22bits/tutupadrummachine/README.md

# tutupadrummachine
Tutupá machine is an arduino-based mechanical drum machine
