22bits/tutupadrummachine/schematic/TUTUPA V2.5sch.brd

## EAGLE design schematic/TUTUPA V2.5sch.brd (2017-04-18)

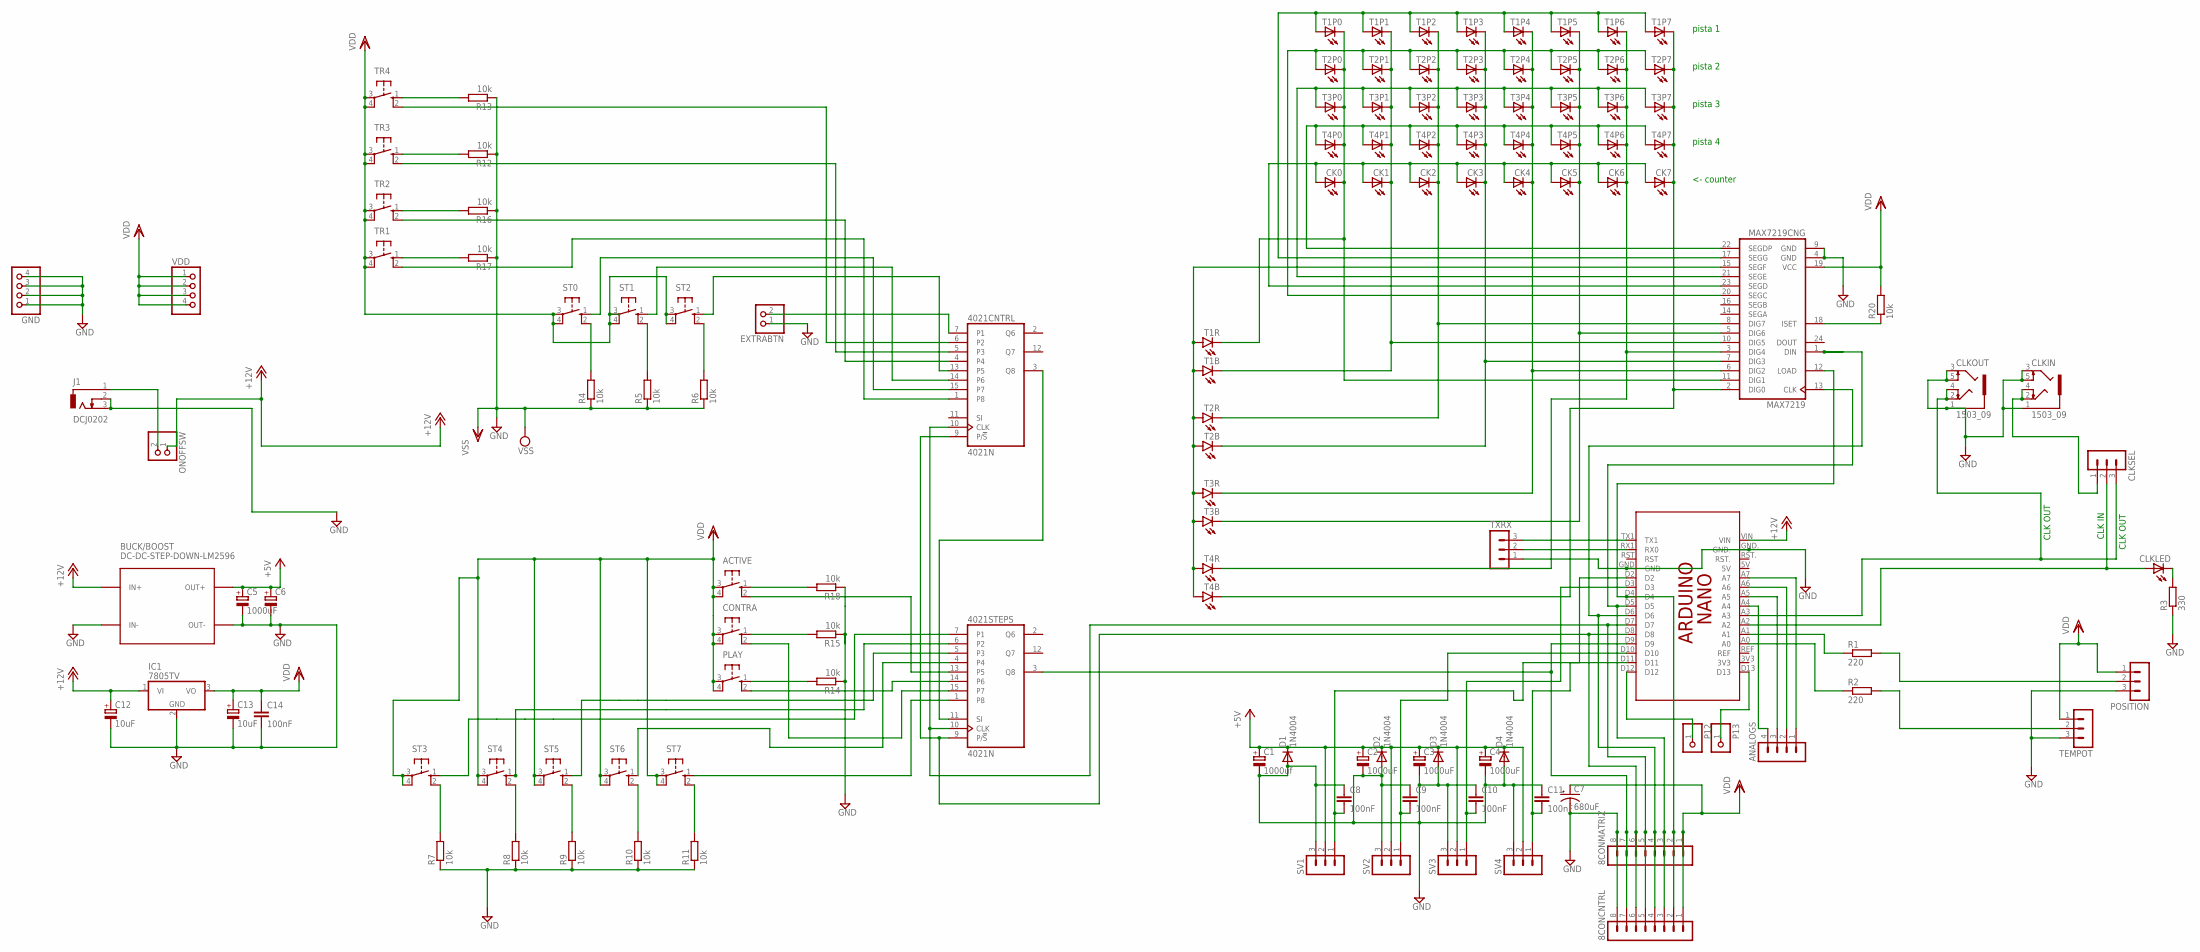
[picture p1: schematic TUTUPA V2.5sch.sch, sheet 1]

Parts:
8CONCNTRL, 8CONMATRIZ: MA08-1W
4021CNTRL, 4021STEPS: 4021N; DIL16
ACTIVE: 10-XX; B3F-10XX
ANALOGS: MA04-1
BUCK/BOOST: DC-DC-STEP-DOWN-LM2596
C1: 1000uf; E5-13
C2, C3, C4, C5: 1000uF; E5-13
C6: CPOL-EUE2.5-6; E2,5-6
C7: 680uF; E5-10,5
C8, C9, C10, C11, C14: 100nF; C050-024X044
C12, C13: 10uF; E1,8-4
CK0, CK1, CK2, CK3, CK4, CK5, CK6, CK7: LED5MM
CLKIN: 1503_09
CLKLED: LED5MM
CLKOUT: 1503_09
CLKSEL: MA03-1
CONTRA: 10-XX; B3F-10XX
D1, D2, D3, D4: 1N4004; DO41-10
EXTRABTN: PINHD-1X2; 1X02
GND: PINHD-1X4; 1X04
IC1: 7805TV; TO220V
J1: DCJ0202
MAX7219: MAX7219CNG; DIL24-3
ONOFFSW: PINHD-1X2; 1X02
P12, P13: PINHD-1X1; 1X01
PCB1: ARDUINO_NANO
PLAY: 10-XX; B3F-10XX
POSITION: MA03-1
R1, R2: 220; 0204/7
R3: 330; 0204/7
R4, R5, R6, R7, R8, R9, R10, R11, R12, R13, R14, R15, R16, R17, R18, R20: 10k; 0207/10
ST0, ST1, ST2, ST3, ST4, ST5, ST6, ST7: 10-XX; B3F-10XX
SV1, SV2, SV3, SV4: MA03-1
T1B, T1R, T2B, T2R, T3B, T3R, T4B, T4R: LED3MM
T1P0, T1P1, T1P2, T1P3, T1P4, T1P5, T1P6, T1P7, T2P0, T2P1, T2P2, T2P3, T2P4, T2P5, T2P6, T2P7, T3P0, T3P1, T3P2, T3P3, T3P4, T3P5, T3P6, T3P7, T4P0, T4P1, T4P2, T4P3, T4P4, T4P5, T4P6, T4P7: LED5MM
TEMPOT: MA03-1
TR1, TR2, TR3, TR4: 10-XX; B3F-10XX
TXRX: MA03-1
VDD: PINHD-1X4; 1X04

Connections:
+5V: BUCK/BOOST.OUT+, C1.+, C2.+, C3.+, C4.+, C5.+, C6.+, D1.C, D2.C, D3.C, D4.C, SV1.2, SV2.2, SV3.2, SV4.2
+12V: BUCK/BOOST.IN+, C12.+, IC1.1 (VI), ONOFFSW.1, PCB1.VIN
CLKINARDUINO: CLKLED.A, CLKSEL.2, PCB1.A2
CLKOUTARDUINO: CLKOUT.2, CLKOUT.4, CLKSEL.3, PCB1.A3
CONIN: CLKIN.2, CLKIN.4, CLKSEL.1
GND: 8CONCNTRL.8, 8CONMATRIZ.8, BUCK/BOOST.IN-, BUCK/BOOST.OUT-, C1.-, C2.-, C3.-, C4.-, C5.-, C6.-, C7.-, C8.1, C9.1, C10.1, C11.1, C12.-, C13.-, C14.2, CLKIN.1, CLKIN.3, CLKIN.5, CLKOUT.1, CLKOUT.3, CLKOUT.5, D1.A, D2.A, D3.A, D4.A, EXTRABTN.1, GND.1, GND.2, GND.3, GND.4, IC1.2 (GND), J1.2, J1.3, MAX7219.4 (GND), MAX7219.9 (GND), PCB1.GND, PCB1.GND., POSITION.3, R3.1, R4.1, R5.1, R6.1, R7.1, R8.1, R9.1, R10.1, R11.1, R12.1, R13.1, R14.1, R15.1, R16.1, R17.1, R18.1, SV1.3, SV2.3, SV3.3, SV4.3, TEMPOT.3, TXRX.1
unnamed: 4021CNTRL.14 (P6), ST1.1 (S)
unnamed: ANALOGS.3, PCB1.A5
unnamed: ANALOGS.2, PCB1.A6
unnamed: ANALOGS.1, PCB1.A7
unnamed: 4021CNTRL.13 (P5), ST2.1 (S)
unnamed: 4021CNTRL.7 (P1), EXTRABTN.2
unnamed: R8.2, ST4.2 (S1)
unnamed: 4021STEPS.1 (P8), ST7.1 (S)
unnamed: R17.2, TR1.1 (S)
unnamed: 4021CNTRL.15 (P7), ST0.1 (S)
unnamed: 4021CNTRL.1 (P8), TR1.2 (S1)
unnamed: 4021CNTRL.4, TR2.2 (S1)
unnamed: MAX7219.15 (SEGF), T1B.A, T1R.A, T2B.A, T2R.A, T3B.A, T3R.A, T4B.A, T4R.A
unnamed: 4021CNTRL.5 (P3), TR3.2 (S1)
unnamed: CONTRA.1 (S), R15.2
unnamed: 4021STEPS.14 (P6), PLAY.2 (S1)
unnamed: 4021STEPS.6 (P2), ST4.1 (S)
unnamed: 4021STEPS.5 (P3), ST5.1 (S)
unnamed: 4021CNTRL.6 (P2), TR4.2 (S1)
unnamed: PLAY.1 (S), R14.2
unnamed: R4.2, ST0.2 (S1)
unnamed: R5.2, ST1.2 (S1)
unnamed: R6.2, ST2.2 (S1)
unnamed: R7.2, ST3.2 (S1)
unnamed: 4021STEPS.7 (P1), ST3.1 (S)
unnamed: R9.2, ST5.2 (S1)
unnamed: R10.2, ST6.2 (S1)
unnamed: R11.2, ST7.2 (S1)
unnamed: R13.2, TR4.1 (S)
unnamed: R12.2, TR3.1 (S)
unnamed: R16.2, TR2.1 (S)
unnamed: 4021STEPS.4, ST6.1 (S)
unnamed: 4021STEPS.15 (P7), CONTRA.2 (S1)
unnamed: 4021STEPS.13 (P5), ACTIVE.2 (S1)
unnamed: ACTIVE.1 (S), R18.2
unnamed: 4021CNTRL.3 (Q8), 4021STEPS.11 (SI)
unnamed: 8CONCNTRL.5, 8CONMATRIZ.5, 4021CNTRL.10 (CLK), 4021STEPS.10 (CLK), PCB1.D7
unnamed: 8CONCNTRL.6, 8CONMATRIZ.6, 4021CNTRL.9 (P/!S), 4021STEPS.9 (P/!S), PCB1.D8
unnamed: 8CONCNTRL.3, 8CONMATRIZ.3, MAX7219.13 (CLK), PCB1.D5
unnamed: 8CONCNTRL.4, 8CONMATRIZ.4, MAX7219.1 (DIN), PCB1.D6
unnamed: 8CONCNTRL.7, 8CONMATRIZ.7, 4021STEPS.3 (Q8), PCB1.D9
unnamed: 8CONCNTRL.2, 8CONMATRIZ.2, MAX7219.12 (LOAD), PCB1.D4
unnamed: MAX7219.18 (ISET), R20.1
unnamed: CK0.A, CK1.A, CK2.A, CK3.A, CK4.A, CK5.A, CK6.A, CK7.A, MAX7219.23 (SEGD)
unnamed: R2.2, TEMPOT.2
unnamed: POSITION.2, R1.2
unnamed: ANALOGS.4, PCB1.A4
unnamed: J1.1, ONOFFSW.2
unnamed: PCB1.A1, R1.1
unnamed: PCB1.A0, R2.1
unnamed: MAX7219.21 (SEGE), T3P0.A, T3P1.A, T3P2.A, T3P3.A, T3P4.A, T3P5.A, T3P6.A, T3P7.A
unnamed: MAX7219.22 (SEGDP), T4P0.A, T4P1.A, T4P2.A, T4P3.A, T4P4.A, T4P5.A, T4P6.A, T4P7.A
unnamed: CK0.K (C), MAX7219.11 (DIG1), T1P0.K (C), T1R.K (C), T2P0.K (C), T3P0.K (C), T4P0.K (C)
unnamed: CK1.K (C), MAX7219.10 (DIG5), T1B.K (C), T1P1.K (C), T2P1.K (C), T3P1.K (C), T4P1.K (C)
unnamed: CK2.K (C), MAX7219.8 (DIG7), T1P2.K (C), T2P2.K (C), T2R.K (C), T3P2.K (C), T4P2.K (C)
unnamed: CK3.K (C), MAX7219.7 (DIG3), T1P3.K (C), T2B.K (C), T2P3.K (C), T3P3.K (C), T4P3.K (C)
unnamed: CK4.K (C), MAX7219.6 (DIG2), T1P4.K (C), T2P4.K (C), T3P4.K (C), T3R.K (C), T4P4.K (C)
unnamed: CK5.K (C), MAX7219.5 (DIG6), T1P5.K (C), T2P5.K (C), T3B.K (C), T3P5.K (C), T4P5.K (C)
unnamed: CK6.K (C), MAX7219.3 (DIG4), T1P6.K (C), T2P6.K (C), T3P6.K (C), T4P6.K (C), T4R.K (C)
unnamed: CK7.K (C), MAX7219.2 (DIG0), T1P7.K (C), T2P7.K (C), T3P7.K (C), T4B.K (C), T4P7.K (C)
unnamed: MAX7219.17 (SEGG), T1P0.A, T1P1.A, T1P2.A, T1P3.A, T1P4.A, T1P5.A, T1P6.A, T1P7.A
unnamed: MAX7219.20 (SEGC), T2P0.A, T2P1.A, T2P2.A, T2P3.A, T2P4.A, T2P5.A, T2P6.A, T2P7.A
unnamed: PCB1.TX1, TXRX.3
unnamed: PCB1.RX1 (RX0), TXRX.2
unnamed: CLKLED.K (C), R3.2
unnamed: P12.1, PCB1.D12
unnamed: P13.1, PCB1.D13
unnamed: C8.2, PCB1.D11, SV1.1
unnamed: C9.2, PCB1.D10, SV2.1
unnamed: C10.2, PCB1.D3, SV3.1
unnamed: C11.2, PCB1.D2, SV4.1
VDD: 8CONCNTRL.1, 8CONMATRIZ.1, 4021CNTRL.16 (VDD), 4021STEPS.16 (VDD), ACTIVE.3, ACTIVE.4 (P1), C7.+, C13.+, C14.1, CONTRA.3, CONTRA.4 (P1), IC1.3 (VO), MAX7219.19 (VCC), PLAY.3, PLAY.4 (P1), POSITION.1, R20.2, ST0.3, ST0.4 (P1), ST1.3, ST1.4 (P1), ST2.3, ST2.4 (P1), ST3.3, ST3.4 (P1), ST4.3, ST4.4 (P1), ST5.3, ST5.4 (P1), ST6.3, ST6.4 (P1), ST7.3, ST7.4 (P1), TEMPOT.1, TR1.3, TR1.4 (P1), TR2.3, TR2.4 (P1), TR3.3, TR3.4 (P1), TR4.3, TR4.4 (P1), VDD.1, VDD.2, VDD.3, VDD.4
VSS: 4021CNTRL.8 (VSS), 4021STEPS.8 (VSS)

Notes on the sheet:
<- counter
pista 1
pista 2
pista 3
pista 4
CLK IN
CLK OUT

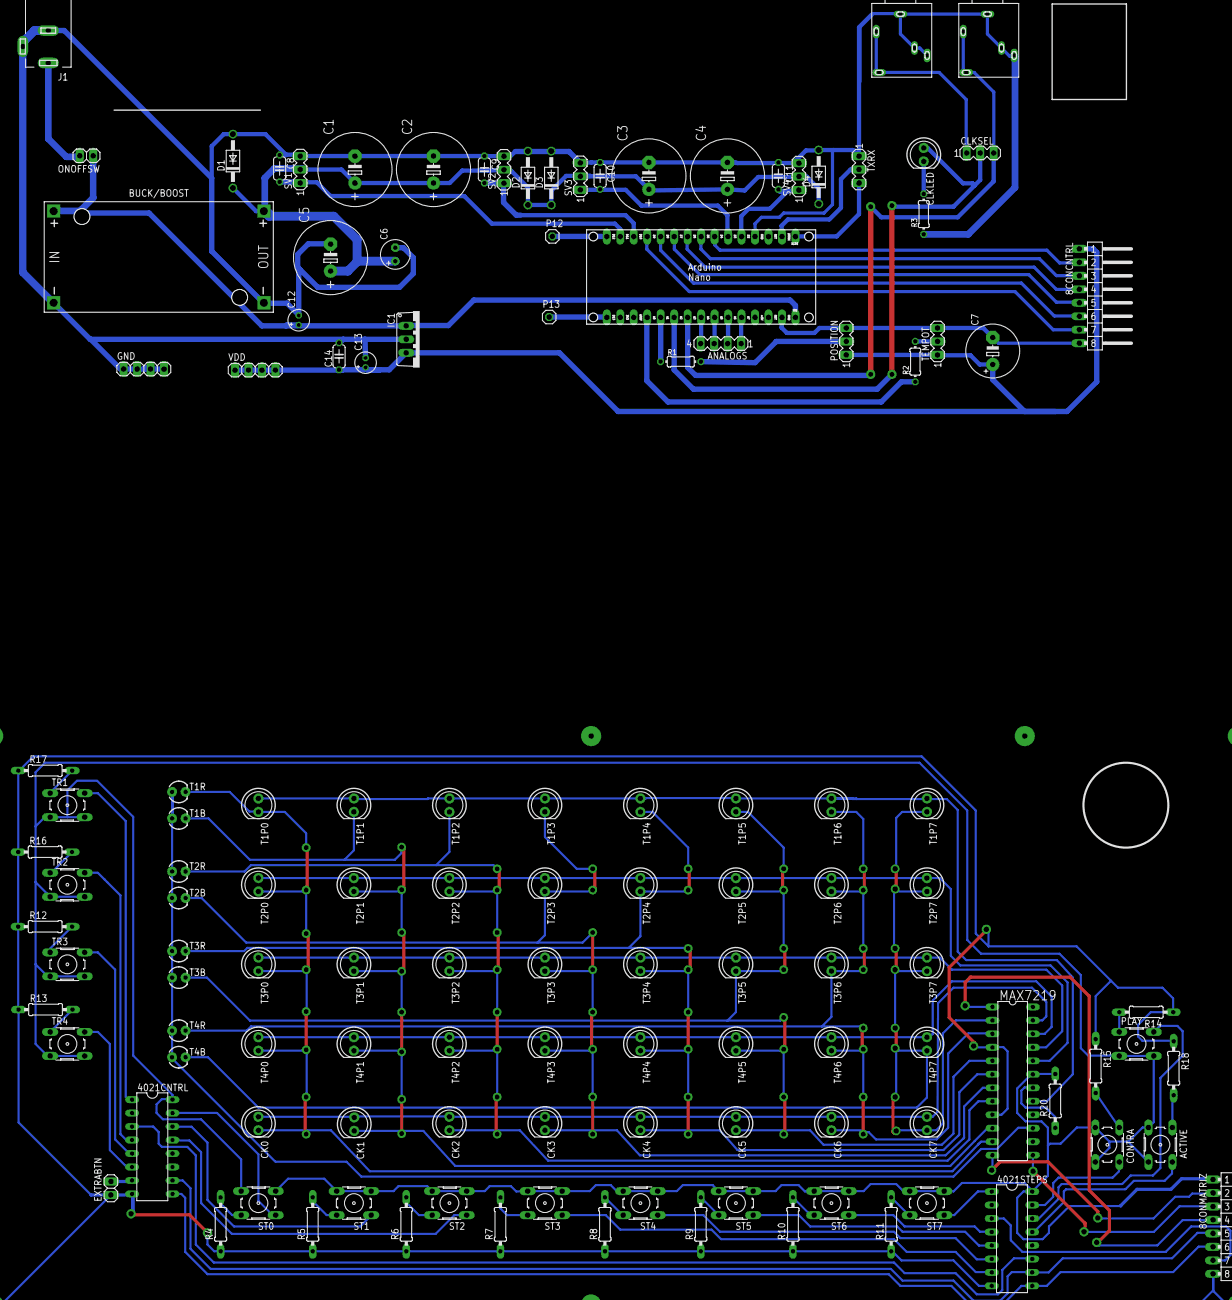
[picture p2: board TUTUPA V2.5sch.brd from above]

Board: 2 copper layers, 127 parts (0 on the bottom side), 79 nets.
